itay-mal/robotic_hand_project/code/ML/README.md

# Classifier Training

## Files

- [train_desicion_forest_2axis.ipynb](train_desicion_forest_2axis.ipynb) - jupyter notebook, expect labeled samples (see [Sequence Labler](https://github.com/itay-mal/sequence_labler)) in directory specified by `sample_files_dir`, outputs classifier object in pickle format later can be loaded by other python modules.  
- [tree_to_code.py](tree_to_code.py) - transforms input classsifier object to cpp file.
