itay-mal/robotic_hand_project/code/on_cpu/README.md

# Trainig Data Collection

## Files

- [on_cpu.ino](on_cpu.ino) - samples IMU measurements and print it over serial connection in dedicated format  
- [inference_on_cpu_random_forest.py](inference_on_cpu_random_forest.py) - runs in cpu connected to the uController via serail com, can be used to save sampled data into csv files, or run classifier inference in cpu.
