itay-mal/robotic_hand_project/reports/CRML_Poster_NITAY_ITAY.pptx

Prosthetic Hand Control via Shoulder Movement

Itay Mal and Nitay Ozer, Supervised by Kobi Kohai

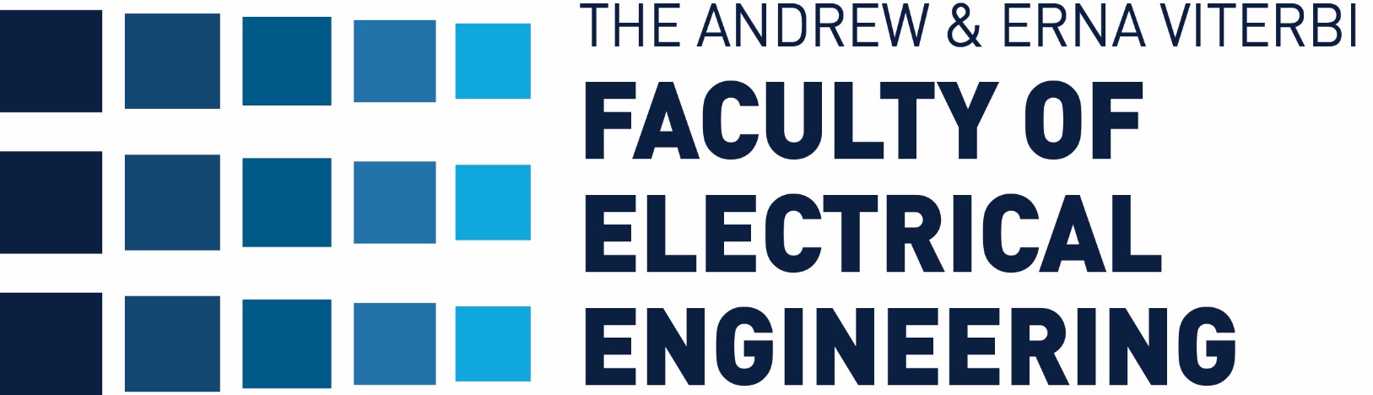
[picture p5: figure]
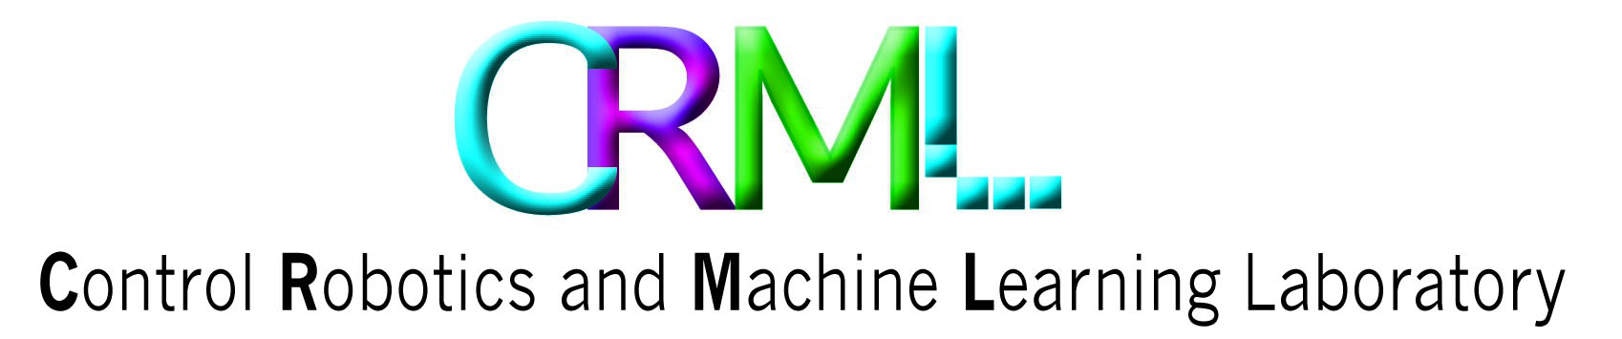
[picture p6: figure]
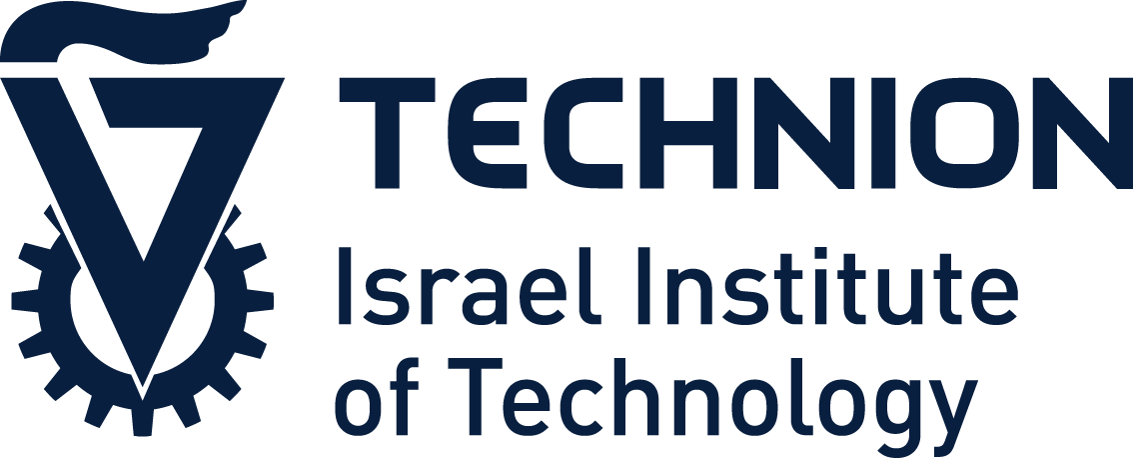
[picture p7: figure]

Introduction

- The project is being carried out in collaboration with the 'Haifa3D' organization, which offers a service of a robotic prosthetic hand that is 3D-printed.
- The hand is provided at no cost to any hand amputee who approaches the organization, customized to their measurements and personal needs.
- In the current state, the hand is controlled by a phone app – the other hand needs to be occupied using the app.

Haifa 3D logo

Goals

- Wirelessly controlling Haifa 3D robotic prosthetic hand.
- Using user’s shoulder movements to activate preset modes instead of using the app.

Block diagram

mode selection

- We chose this approach for cycling between modes:
- Pros:
  - Easy movement identification.
  - Few actions to remember.
- Cons:
  - Less immediate operation.
  - Need to remember state sequence.

Next Mode

On/Off

Mode Navigation

- Number of modes and their associated actions are configurable by software.
- For safety and reliability - can cycle through modes only when idle.

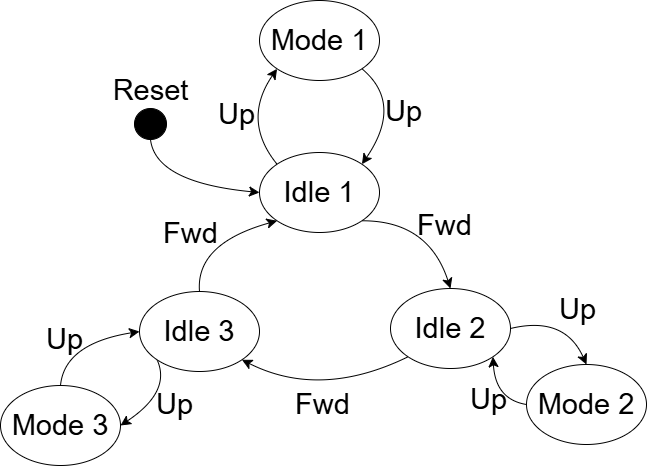
[picture p8: figure]
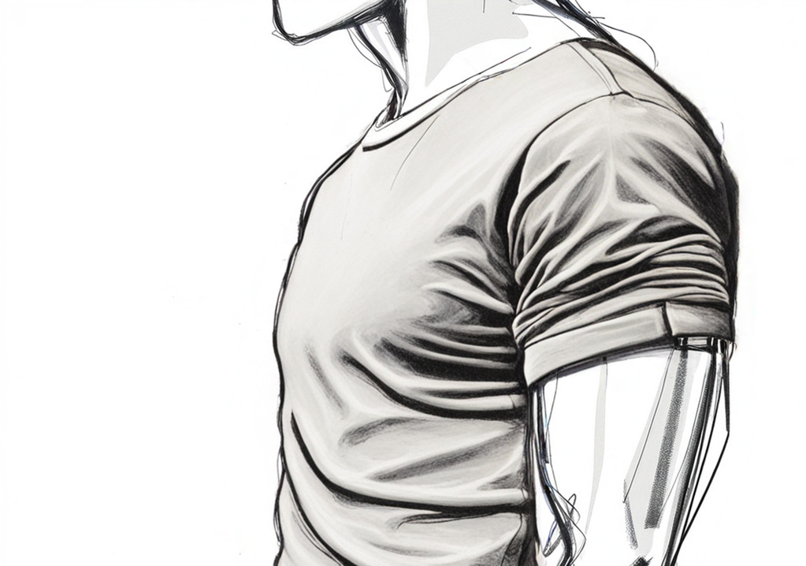
[picture p9: figure]
Haifa3D - תנו לי יד בתלת מימד | Haifa

Program Flow

- Sample in 80 [Hz] frequency.
- Add sample to buffer – contains last 100 samples.
- Check if enough time have passed from last prediction to avoid multiple predictions from the same movement.
- Make prediction.

Classification Algorithm

- Pros:
  - Easy and fast training.
  - Highly fitted to classification tasks.
  - Explainable.
  - Fitted to microcontroller easily.
- Cons:
  - Not designed for temporal data.

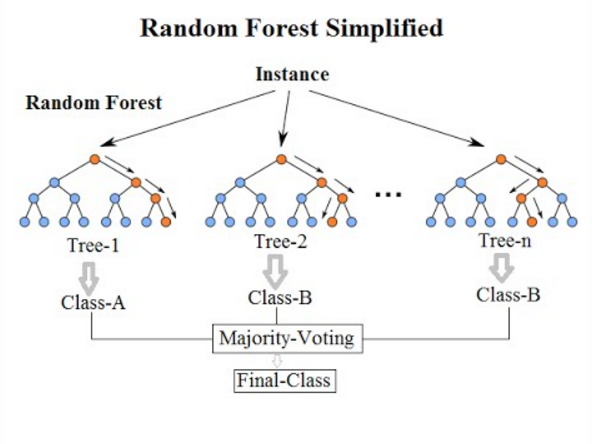
[picture p10: figure]
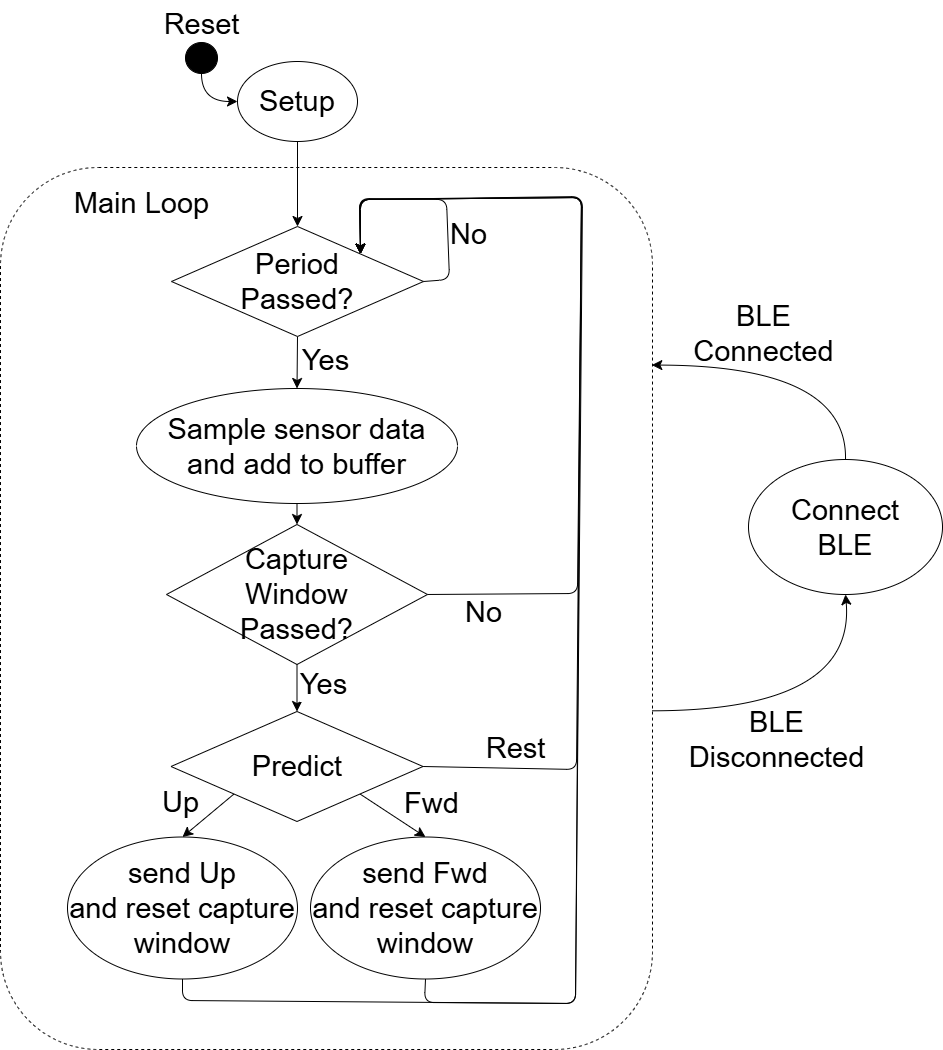
[picture p11: figure]

Shoulder Movement

Our System

IMU Sensors

ESP32

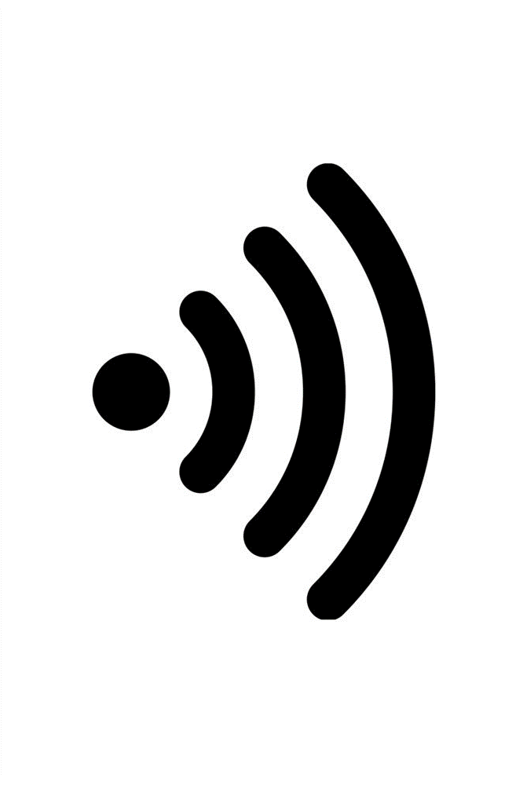
[picture p12: figure]
Wifi Symbol Stamp
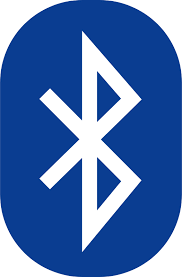
[picture p13: figure]
List of Bluetooth profiles - Wikipedia
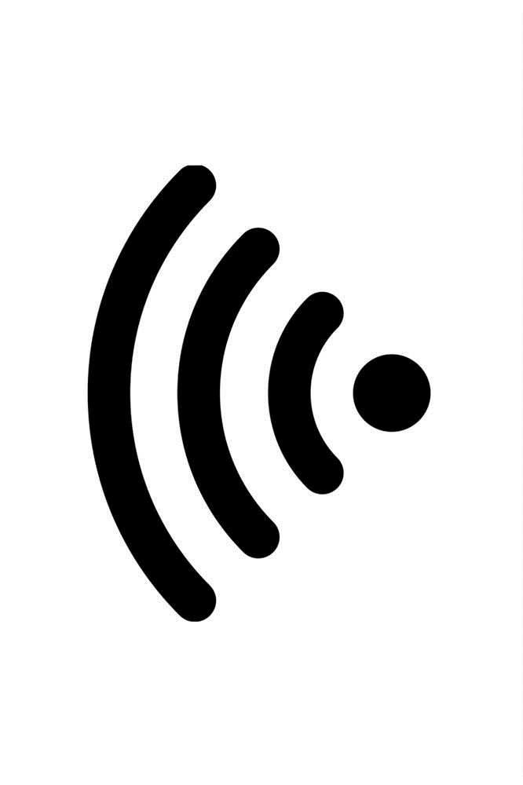
[picture p14: figure]
Wifi Symbol Stamp

Challenges

Conclusions

- Managed to successfully achieve project goals:
  - Reliably classify target gestures.
  - Low false positive rate.
  - Stable wireless connection.
- More research need to be done in order to make a final product:
  - Improve classification accuracy.
  - Battery life testing and optimization.
  - Detect more gestures.
  - Improve physical product.
  - User feedback.

- Establishing a stable BLE connection between the hand and the controller.
- Choosing the best configuration of IMU’s in order to get the best shoulder movement samples:
  - Number of sensors.
  - Locations on the shoulder and body.
- Deciding the best approach for mode selection.
- Finding the right classification algorithm for our task that can fit a microcontroller:
  - Need to be Computationally light.
  - Need to take little memory.
  - Need to be easily implemented on microcontroller.
- No previous data set exists.

Data Acquisition

- ESP connected to computer to collect sample traces to CSV files.
- Traces include target gestures as well as miscellaneous activities.

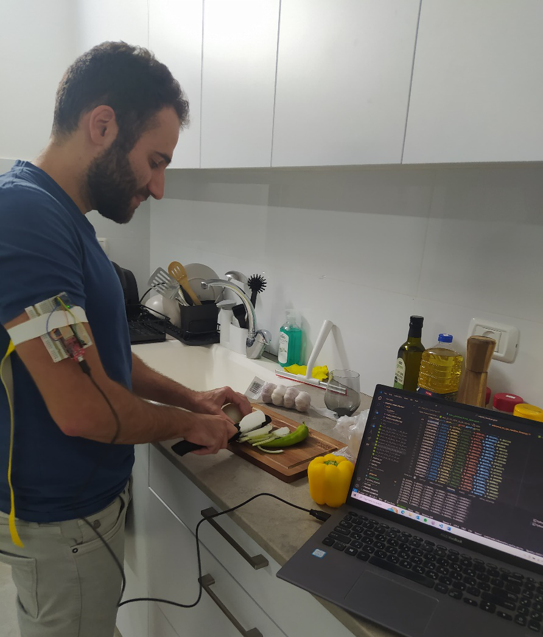
[picture p15: figure]

September 2016
