itay-mal/robotic_hand_project/reports/דוח אפיון פרויקט - נתאי ואיתי.pdf

# המעבדה לבקרה רובוטיקה ולמידה חישובית

# דו"ח אפיון פרויקט

שם הפרויקט: פיתוח מערכת שליטה על יד תותבת בעזרת תנועות כתף .

מנחה: קובי כוחי .

סטודנטים: איתי מאל ונתאי עוזר .

סמסטר: אביב תשפ''ג תאריך הגשה: 30.4.23 .

### מטרת המסמך : סיכום תמציתי ) כארבעה דפים( הכולל הגדרות מלאות ומעודכנות

של הפרויקט ושל הסטאטוס הנוכחי שלו.

## תוכן

## .1 לו"ז למשימות

| | | | מס' משימה תאור משך הערות
| חודש | נבין את מימוש היד הקיימת ואת דרכי ההתממשקות אליה | תיאורטי | 1 למידת חומר
נציגים מהעמותה/ קטועי יד להתייעצות לגבי תנועות כתף אפשריות. | חודש • פגישה עם | לאפיין את הפקודות הרצויות שנשלח ליד ומ ה הן התנועות שיבוצעו על מנת להפעילן | תנועות כתף אפשריות | 2 לאפיין
| חודש וחצי | להבין כמה חיישים והיכן נרצה למקמם על מנת לקלוט את התנועות הרצויות באופן הטוב ביותר. בנוסף, כתיבת קוד שמקבל מידע מהחיישנים ושולח פקודות ליד בהתאם. | רכישת התנועה ויצירת דטה סט על התנועות. | 3 מימוש של

חודש וחצי | ננסה את המוצר הראשוני בעזרת משתמשים שונים ונשפר את המוצר לפי חוות הדעת של המשתמשים | חוות דעת על אופן הפעולה | 4 ניסוי וקבלת
חוד ש | שילוב של המערכת שלנו עם השיטות השונות )שליטה בעזרת הרגל, גלי מוח וכו'...( על מנת לקבל את המוצר הטוב ביותר | אינטגרציה עם הפרוייקטים האחרים בנושא | 5 אופציונלי:

## .2 תרשים התקדמות )גאנט(

| פעילות מספר חודשים ממועד התחלת העבודה
1 | 2 | 3 | 4 | 5 | 6 | 7 | 8 | 9
| | | | | | | | | 1
| | | | | | | | | 2
| | | | | | | | | | 3
| | | | | | | | | | 4
| | | | | | | | | | 5

## .3 רקע

יד תותבת אלקטרונית, המשמשת קטועי ידיים, פותחה לאחרונה ע"י עמותת D3 Haifa. התותבת מסופקת בחינם לנכים קטועי יד מתחת למרפק. ומאפשרת שליטה על ארבע אצבעות וסיבוב כף היד.

בפרויקט נפתח מערכת שתעשה שימוש בחישה של תנועות רצוניות קטנות בכתף )מעלה מטה, קדימה אחורה, תנועת היד, וכו''.( והמרתם לאותות דיגיטליים שישלחו פקודות בתקשורת Bluetooth ליד התותבת לצורך שליטה על תנועת האצבעות.

נעבו ד בשיתוף פעולה עם נכים ועמותת חיפה D3 Haifa.

## .4 מטרת הפרויקט

מימוש מערכת שמזהה תנועות כתף מוגדרות ושולחת פקודות למערכת היד בהתאם לתנועה שזוההתה.

## .5 תוצאות בדיקת היתכנות ראשונית

מטרות הפרויקט ניתנות למימוש. ניתן לראות בפרוייקט של שונית כבדיקת היתכנות לפרוייקט שלנו.

## .6 סביבת עבודה

- מעבד 32ESP.
- חיישנים אינרציאליים .
- מטלב/פייתון.

## .7 תחומי ידע נדרשים

- עבודה עם מדי תאוצה.
- תכנות עבור מעבד 32ESP.
- הכרת פרוטוקול Bluetooth.
- ידע בסיסי במערכות לומדות.
- ידע בעיבוד אותות.

## .8 סיכום תמציתי של סקר הספרות

- חיישנים אינרציאלים – חיישני תנועה אינרציאלים מודדים תנועה ביחס למערכת צירים כלשהי, אשר בעצמה יכולה להיות בתנועה אך יש לשים לב שתאוצות וכוחות שפועלים על המערכת יכולים להשפיעה על המדידות האינרציאליות . חיישנים אינרציאלים נפוצים הם אקסלר ומטרים וג'יירוסקופים.
- אקסלר ומטרים – מודדים את תאוצת הגוף על ידי שימוש בחוק השני של ניוטון. לרוב משלבים מעגלים חשמליים עם מערכות מכאניות ) systems electromechanical-Micro (MEMS )(שמנצלות תכונות ו אפקטים כמו פיאזואלקטריות או שינויים בקיבול על מנת לחשב את הכוח המופעל על החיישן ומכאן לחלץ את התאוצה. כיום קיים מגוון רב של חיישנים אמינים בעלי נפח קטן, משקל קל וזול ים מאוד.
- ג'יירוסקופים – מודדים מהירות זוויתית על ידי ניצול תופעות פיזיקליות שונות כגון כח קוריוליס . בעיקר נפוצים ג'יירוסקופים מבוססי MEMS שכן הם קטנים מאוד וזולים ובעלי רמת אמינות טובה מספיק למירב המימושים.

- מנגנוני שליטה על ידיים תותבות –
- מנגנונים מכאנים – מערכת לרוב של רצועות כנגד קפיצים שכן תנועות מסוימות של הגוף מותחות רצועות מסוימות וכך גורמות לפתיחה של היד ו בהרפיית המתיחה הקפיץ סוגר את היד.
- שליטה בעזרת מערכת העצבים – בעיק ר מחקרי. בקרה על יד רובוטית בעזרת מדידת הסיגנלים שמגיעים מהמוח לעצבים הקטועים. חסרונה העיקרי של שיטה זו הוא שכתוצאה של פעילות עצבים אלו יכולים להגרם כאבי פנטום.
- שיטות מבוססות חיזוי – שימוש בראיה ממוחשבת או קינמטיקה, איפיון תנועה של חלקים סמוכים ליד , כאשר מבצעים פעו לה מסויימת למשל הושטת היד לצורך אחיזה . המערכת משתמשת במודלים שונים לחיזוי רצון המשתמש ומפעילה את היד בהתאם.

## .9 מפרט הדרישות

- נוח לשימוש ומשקל נמוך.
- הפעלה על ידי תנועות עדינות וטב עיות.
- חיי סוללה ארוכים )שיוכל להחזיק יום שלם בחוץ (.
- דיוק גבוהה בקליטת התנועות ובלי זיהויי שו וא .

## .10 פתרונות חלופיים

- מנגנוני שליטה אחרים כגון: על ידי תנועות רגל או גלי מוח.
- ידיים מכאניות הקי ימות בשוק כיום.

## .11 סכמת בלוקים

## .12 שיטת בחינת טיב התוצאות

### על ידי מבחן פונקציונלי המדמה שימוש יומיומי במערכת תוך הפעלת מאפייניה השונים. יבדקו ספי הרגישות של המערכת, דיוק וזיהויי שווא .בנוסף, נקבל חוות

דעת סובייקטיבית לגבי נוחות השימוש.

חיישני תנועה תנועת כתף

יחידת בקרה יד רובוטית
