itay-mal/robotic_hand_project/readme_src/17381-SparkFun_Thing_Plus_-_ESP32_WROOM__U.FL_-04.jpg

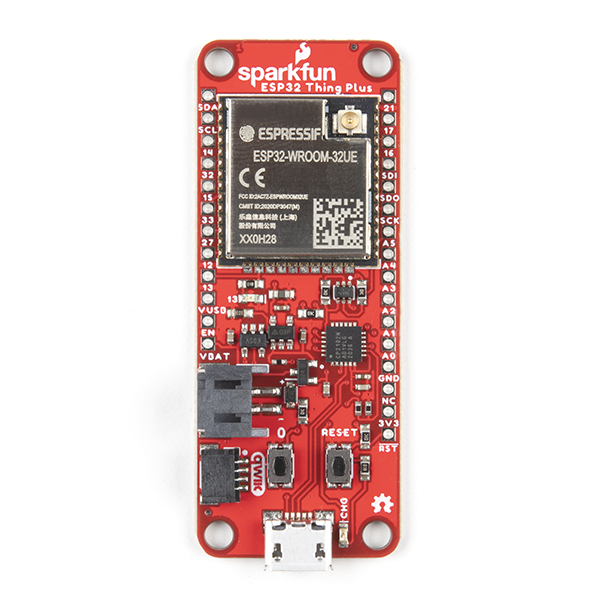
readme_src/17381-SparkFun_Thing_Plus_-_ESP32_WROOM__U.FL_-04.jpg
