itay-mal/robotic_hand_project/references/thing_plus_dimensions.png

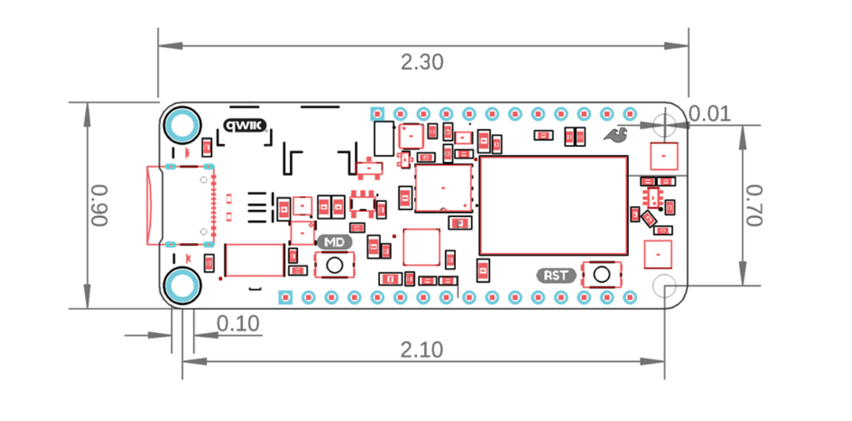
references/thing_plus_dimensions.png
