itay-mal/robotic_hand_project/reports/system_state_machine.drawio.png

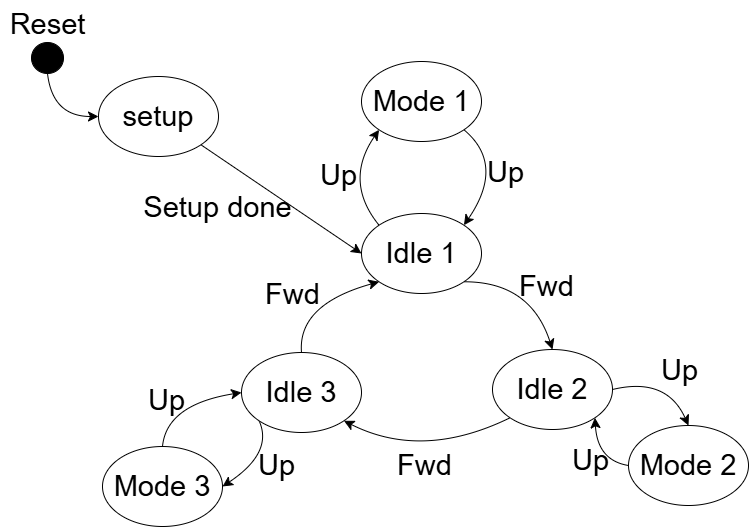
reports/system_state_machine.drawio.png
