itay-mal/robotic_hand_project/box_3d/bottom.stl

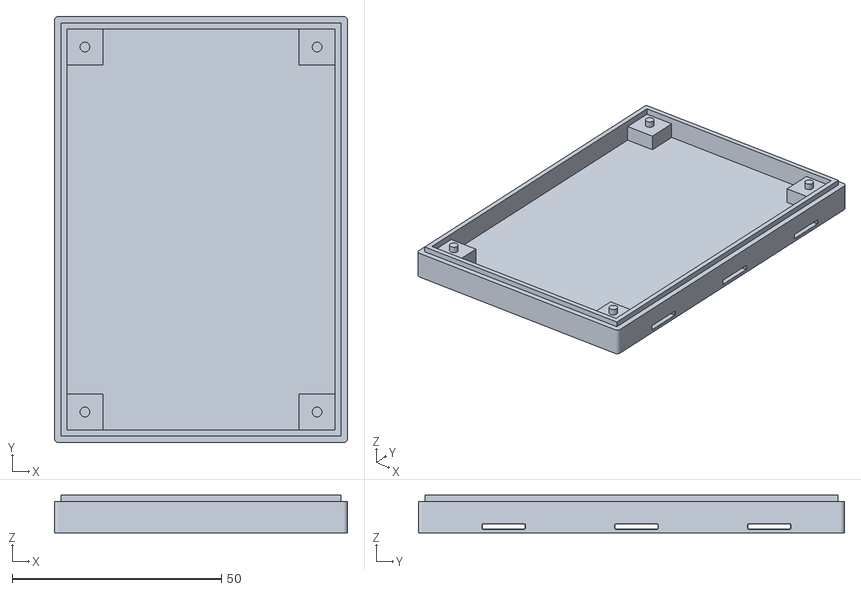
[picture p44: CAD file, 2024-07-11]
box_3d/bottom.stl
70.1 x 101.9 x 9.00
