itay-mal/robotic_hand_project/box_3d/top.stl

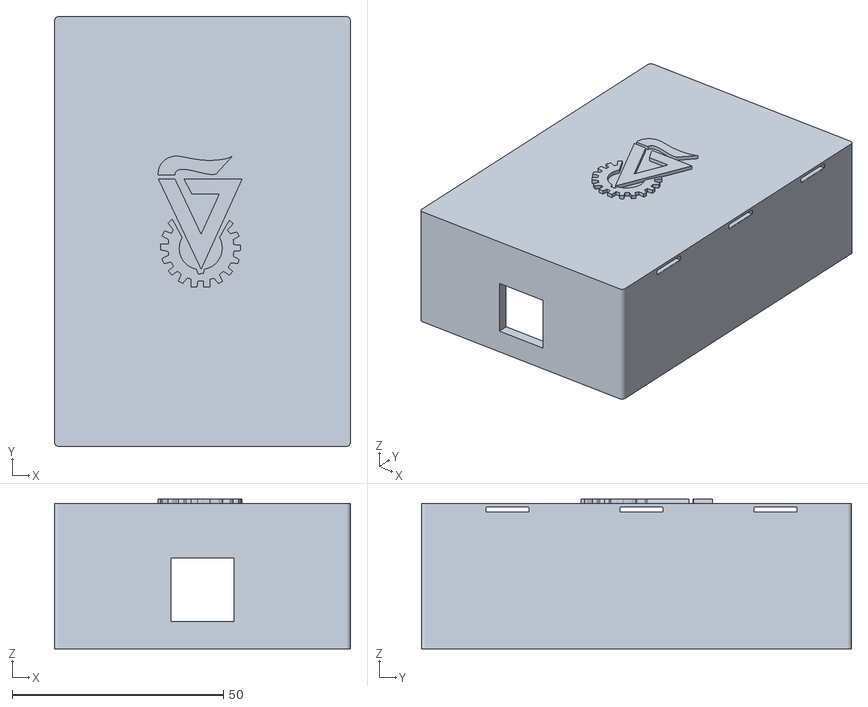
[picture p45: CAD file, 2024-07-11]
box_3d/top.stl
70.1 x 101.9 x 35.5
