itay-mal/robotic_hand_project/code/on_esp32_ble/forrest.hpp

#ifndef RF_PREDICT
#define RF_PREDICT
void rf_predict(float *in, int *cls_hist){
#define NUM_TREES 20
#define NUM_CLASSES 3
#define NUM_FEATURES 600
	// tree 0
    if(in[160] <= 0.68) {
        if(in[221] <= -0.47) {
            if(in[67] <= 9.70) {
                cls_hist[0]++;
            }
            else {
                if(in[234] <= 0.55) {
                    if(in[395] <= -0.07) {
                        cls_hist[0]++;
                    }
                    else {
                        cls_hist[1]++;
                    }
                }
                else {
                    cls_hist[0]++;
                }
            }
        }
        else {
            if(in[385] <= 13.38) {
                if(in[124] <= 1.60) {
                    cls_hist[0]++;
                }
                else {
                    if(in[22] <= -0.26) {
                        cls_hist[0]++;
                    }
                    else {
                        cls_hist[2]++;
                    }
                }
            }
            else {
                cls_hist[1]++;
            }
        }
    }
    else {
        if(in[115] <= 12.77) {
            if(in[106] <= 1.59) {
                if(in[168] <= -0.78) {
                    if(in[58] <= 0.19) {
                        cls_hist[0]++;
                    }
                    else {
                        cls_hist[2]++;
                    }
                }
                else {
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
            }
            else {
                if(in[558] <= 0.47) {
                    cls_hist[0]++;
                }
                else {
                    cls_hist[2]++;
                }
            }
        }
        else {
            cls_hist[0]++;
        }
    }
    
}
#endif
