itay-mal/robotic_hand_project/(commit log)

2023-11-01 BLE client (python) and server (esp32)
2024-01-30 add data labels and print info to file
2024-07-09 finito la coda
2024-07-11 update readme, add box STLs
    [bottom.stl, top.stl]
